sushihangover/SupermodifiedServo/EagleFiles/render.JPG

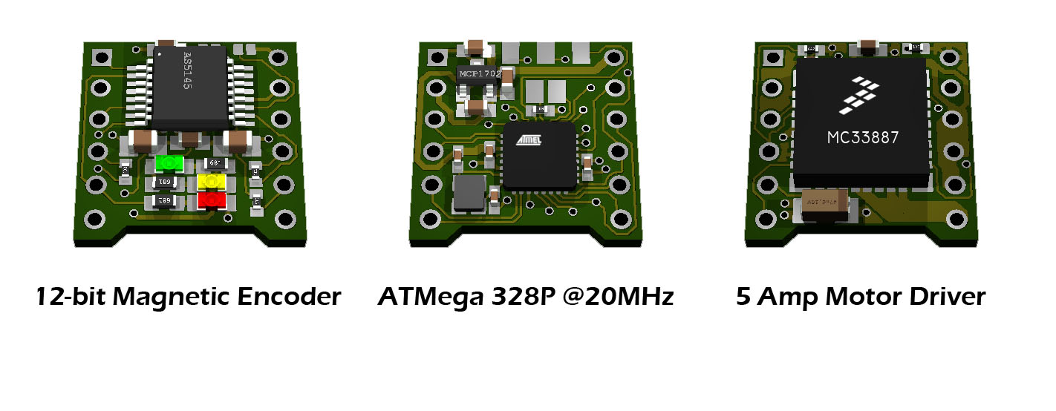
EagleFiles/render.JPG
