sushihangover/SupermodifiedServo/OldSite/MetalPotModification.pdf

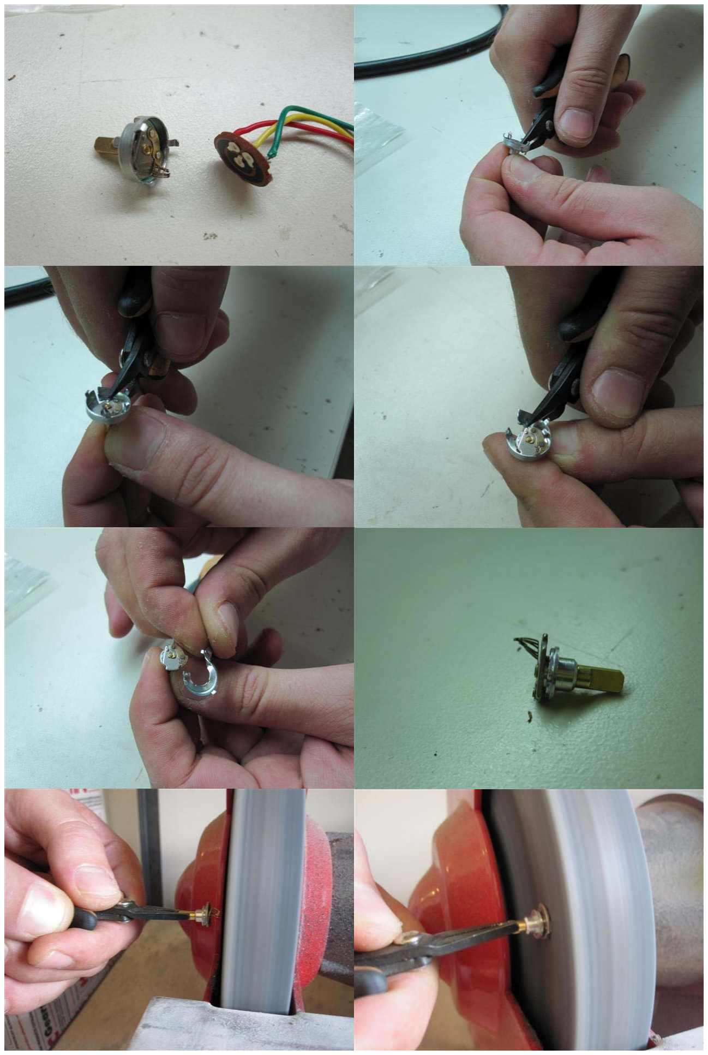
[picture p2: figure]

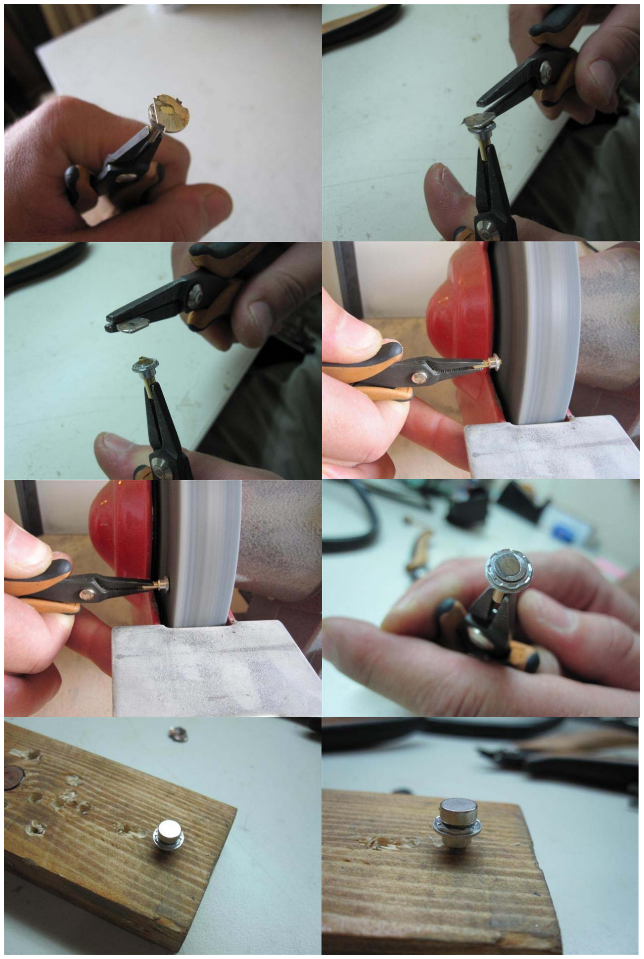
[picture p3: figure]
