sushihangover/SupermodifiedServo/ArduinoApiC/Debug/BuildLog.htm

Build Log

| | Rebuild started: Project: SuperModifiedMaster, Configuration: Debug|Win32

Command Lines

| | Creating temporary file "C:\DOCUME~1\giannis\LOCALS~1\Temp\BAT00000117923924.bat" with contents [ @echo off make clean make all if errorlevel 1 goto VCReportError goto VCEnd :VCReportError echo Project : error PRJ0019: A tool returned an error code from "Performing Makefile project actions" exit 1 :VCEnd ] Creating command line "C:\DOCUME~1\giannis\LOCALS~1\Temp\BAT00000117923924.bat"

Output Window

Performing Makefile project actions
-------- begin --------
Cleaning project:
rm -f main.hex
rm -f main.eep
rm -f main.cof
rm -f main.elf
rm -f main.map
rm -f main.sym
rm -f main.lss
rm -f ./obj/zoAdc.o ./obj/zoSystemTimer.o ./obj/zoI2c.o ./obj/zoBuffer.o ./obj/zoUart.o ./obj/zoError.o ./obj/zoProtocol.o ./obj/zoProtocolI2c.o ./obj/zoProtocolUart.o ./obj/zoCommands.o ./obj/zoSmsMaster.o ./obj/main.o
rm -f ./obj/zoAdc.lst ./obj/zoSystemTimer.lst ./obj/zoI2c.lst ./obj/zoBuffer.lst ./obj/zoUart.lst ./obj/zoError.lst ./obj/zoProtocol.lst ./obj/zoProtocolI2c.lst ./obj/zoProtocolUart.lst ./obj/zoCommands.lst ./obj/zoSmsMaster.lst ./obj/main.lst
rm -f zoAdc.s zoSystemTimer.s zoI2c.s zoBuffer.s zoUart.s zoError.s zoProtocol.s zoProtocolI2c.s zoProtocolUart.s zoCommands.s zoSmsMaster.s main.s
rm -f zoAdc.d zoSystemTimer.d zoI2c.d zoBuffer.d zoUart.d zoError.d zoProtocol.d zoProtocolI2c.d zoProtocolUart.d zoCommands.d zoSmsMaster.d main.d
rm -f zoAdc.i zoSystemTimer.i zoI2c.i zoBuffer.i zoUart.i zoError.i zoProtocol.i zoProtocolI2c.i zoProtocolUart.i zoCommands.i zoSmsMaster.i main.i
rm -rf .dep
-------- end --------
-------- begin --------
avr-gcc (WinAVR 20100110) 4.3.3
Copyright (C) 2008 Free Software Foundation, Inc.
This is free software; see the source for copying conditions. There is NO
warranty; not even for MERCHANTABILITY or FITNESS FOR A PARTICULAR PURPOSE.
Compiling C: zoAdc.c
avr-gcc -c -mmcu=atmega328p -I. -gdwarf-2 -DF_CPU=16000000UL -O2 -funsigned-char -funsigned-bitfields -fpack-struct -fshort-enums -Wall -Wstrict-prototypes -Wa,-adhlns=./obj/zoAdc.lst -std=gnu99 -MMD -MP -MF .dep/zoAdc.o.d zoAdc.c -o obj/zoAdc.o
Compiling C: zoSystemTimer.c
avr-gcc -c -mmcu=atmega328p -I. -gdwarf-2 -DF_CPU=16000000UL -O2 -funsigned-char -funsigned-bitfields -fpack-struct -fshort-enums -Wall -Wstrict-prototypes -Wa,-adhlns=./obj/zoSystemTimer.lst -std=gnu99 -MMD -MP -MF .dep/zoSystemTimer.o.d zoSystemTimer.c -o obj/zoSystemTimer.o
Compiling C: zoI2c.c
avr-gcc -c -mmcu=atmega328p -I. -gdwarf-2 -DF_CPU=16000000UL -O2 -funsigned-char -funsigned-bitfields -fpack-struct -fshort-enums -Wall -Wstrict-prototypes -Wa,-adhlns=./obj/zoI2c.lst -std=gnu99 -MMD -MP -MF .dep/zoI2c.o.d zoI2c.c -o obj/zoI2c.o
Compiling C: zoBuffer.c
avr-gcc -c -mmcu=atmega328p -I. -gdwarf-2 -DF_CPU=16000000UL -O2 -funsigned-char -funsigned-bitfields -fpack-struct -fshort-enums -Wall -Wstrict-prototypes -Wa,-adhlns=./obj/zoBuffer.lst -std=gnu99 -MMD -MP -MF .dep/zoBuffer.o.d zoBuffer.c -o obj/zoBuffer.o
Compiling C: zoUart.c
avr-gcc -c -mmcu=atmega328p -I. -gdwarf-2 -DF_CPU=16000000UL -O2 -funsigned-char -funsigned-bitfields -fpack-struct -fshort-enums -Wall -Wstrict-prototypes -Wa,-adhlns=./obj/zoUart.lst -std=gnu99 -MMD -MP -MF .dep/zoUart.o.d zoUart.c -o obj/zoUart.o
Compiling C: zoError.c
avr-gcc -c -mmcu=atmega328p -I. -gdwarf-2 -DF_CPU=16000000UL -O2 -funsigned-char -funsigned-bitfields -fpack-struct -fshort-enums -Wall -Wstrict-prototypes -Wa,-adhlns=./obj/zoError.lst -std=gnu99 -MMD -MP -MF .dep/zoError.o.d zoError.c -o obj/zoError.o
Compiling C: zoProtocol.c
avr-gcc -c -mmcu=atmega328p -I. -gdwarf-2 -DF_CPU=16000000UL -O2 -funsigned-char -funsigned-bitfields -fpack-struct -fshort-enums -Wall -Wstrict-prototypes -Wa,-adhlns=./obj/zoProtocol.lst -std=gnu99 -MMD -MP -MF .dep/zoProtocol.o.d zoProtocol.c -o obj/zoProtocol.o
Compiling C: zoProtocolI2c.c
avr-gcc -c -mmcu=atmega328p -I. -gdwarf-2 -DF_CPU=16000000UL -O2 -funsigned-char -funsigned-bitfields -fpack-struct -fshort-enums -Wall -Wstrict-prototypes -Wa,-adhlns=./obj/zoProtocolI2c.lst -std=gnu99 -MMD -MP -MF .dep/zoProtocolI2c.o.d zoProtocolI2c.c -o obj/zoProtocolI2c.o
Compiling C: zoProtocolUart.c
avr-gcc -c -mmcu=atmega328p -I. -gdwarf-2 -DF_CPU=16000000UL -O2 -funsigned-char -funsigned-bitfields -fpack-struct -fshort-enums -Wall -Wstrict-prototypes -Wa,-adhlns=./obj/zoProtocolUart.lst -std=gnu99 -MMD -MP -MF .dep/zoProtocolUart.o.d zoProtocolUart.c -o obj/zoProtocolUart.o
Compiling C: zoCommands.c
avr-gcc -c -mmcu=atmega328p -I. -gdwarf-2 -DF_CPU=16000000UL -O2 -funsigned-char -funsigned-bitfields -fpack-struct -fshort-enums -Wall -Wstrict-prototypes -Wa,-adhlns=./obj/zoCommands.lst -std=gnu99 -MMD -MP -MF .dep/zoCommands.o.d zoCommands.c -o obj/zoCommands.o
Compiling C: zoSmsMaster.c
avr-gcc -c -mmcu=atmega328p -I. -gdwarf-2 -DF_CPU=16000000UL -O2 -funsigned-char -funsigned-bitfields -fpack-struct -fshort-enums -Wall -Wstrict-prototypes -Wa,-adhlns=./obj/zoSmsMaster.lst -std=gnu99 -MMD -MP -MF .dep/zoSmsMaster.o.d zoSmsMaster.c -o obj/zoSmsMaster.o
Compiling C: main.c
avr-gcc -c -mmcu=atmega328p -I. -gdwarf-2 -DF_CPU=16000000UL -O2 -funsigned-char -funsigned-bitfields -fpack-struct -fshort-enums -Wall -Wstrict-prototypes -Wa,-adhlns=./obj/main.lst -std=gnu99 -MMD -MP -MF .dep/main.o.d main.c -o obj/main.o
Linking: main.elf
avr-gcc -mmcu=atmega328p -I. -gdwarf-2 -DF_CPU=16000000UL -O2 -funsigned-char -funsigned-bitfields -fpack-struct -fshort-enums -Wall -Wstrict-prototypes -Wa,-adhlns=obj/zoAdc.o -std=gnu99 -MMD -MP -MF .dep/main.elf.d obj/zoAdc.o obj/zoSystemTimer.o obj/zoI2c.o obj/zoBuffer.o obj/zoUart.o obj/zoError.o obj/zoProtocol.o obj/zoProtocolI2c.o obj/zoProtocolUart.o obj/zoCommands.o obj/zoSmsMaster.o obj/main.o --output main.elf -Wl,-Map=main.map,--cref -lm
Creating load file for Flash: main.hex
avr-objcopy -O ihex -R .eeprom -R .fuse -R .lock main.elf main.hex
Creating load file for EEPROM: main.eep
avr-objcopy -j .eeprom --set-section-flags=.eeprom="alloc,load" \
--change-section-lma .eeprom=0 --no-change-warnings -O ihex main.elf main.eep || exit 0
Creating Extended Listing: main.lss
avr-objdump -h -S -z main.elf > main.lss
Creating Symbol Table: main.sym
avr-nm -n main.elf > main.sym
Size after:
AVR Memory Usage
----------------
Device: atmega328p
Program: 11598 bytes (35.4% Full)
(.text + .data + .bootloader)
Data: 315 bytes (15.4% Full)
(.data + .bss + .noinit)
-------- end --------

Results

| | Build log was saved at "file://d:\01server\01mech\Products\Supermodified\Technical\Source\svn\ArduinoApiC\Debug\BuildLog.htm" SuperModifiedMaster - 0 error(s), 0 warning(s)
