sushihangover/SupermodifiedServo/SuperModified.V2.32bit.Velocities/Debug/BuildLog.htm

Build Log

| | Rebuild started: Project: zoSuperModified, Configuration: Debug|Win32

Command Lines

| | Creating temporary file "C:\DOCUME~1\giannis\LOCALS~1\Temp\BAT00000214723364.bat" with contents [ @echo off make clean make all if errorlevel 1 goto VCReportError goto VCEnd :VCReportError echo Project : error PRJ0019: A tool returned an error code from "Performing Makefile project actions" exit 1 :VCEnd ] Creating command line "C:\DOCUME~1\giannis\LOCALS~1\Temp\BAT00000214723364.bat"

Output Window

Performing Makefile project actions
-------- begin --------
Cleaning project:
rm -f main.hex
rm -f main.eep
rm -f main.cof
rm -f main.elf
rm -f main.map
rm -f main.sym
rm -f main.lss
rm -f ./obj/zoError.o ./obj/zoSystemTimer.o ./obj/zoProtocol.o ./obj/zoEncoder.o ./obj/zoMotor.o ./obj/zoPid.o ./obj/zoSms.o ./obj/zoSmsError.o ./obj/zoCommands.o ./obj/zoAdc.o ./obj/zoSpi.o ./obj/zoI2c.o ./obj/zoProtocolI2c.o ./obj/zoUart.o ./obj/zoProtocolUart.o ./obj/zoBuffer.o ./obj/zoIcp.o ./obj/zoProtocolRcServo.o ./obj/main.o
rm -f ./obj/zoError.lst ./obj/zoSystemTimer.lst ./obj/zoProtocol.lst ./obj/zoEncoder.lst ./obj/zoMotor.lst ./obj/zoPid.lst ./obj/zoSms.lst ./obj/zoSmsError.lst ./obj/zoCommands.lst ./obj/zoAdc.lst ./obj/zoSpi.lst ./obj/zoI2c.lst ./obj/zoProtocolI2c.lst ./obj/zoUart.lst ./obj/zoProtocolUart.lst ./obj/zoBuffer.lst ./obj/zoIcp.lst ./obj/zoProtocolRcServo.lst ./obj/main.lst
rm -f zoError.s zoSystemTimer.s zoProtocol.s zoEncoder.s zoMotor.s zoPid.s zoSms.s zoSmsError.s zoCommands.s zoAdc.s zoSpi.s zoI2c.s zoProtocolI2c.s zoUart.s zoProtocolUart.s zoBuffer.s zoIcp.s zoProtocolRcServo.s main.s
rm -f zoError.d zoSystemTimer.d zoProtocol.d zoEncoder.d zoMotor.d zoPid.d zoSms.d zoSmsError.d zoCommands.d zoAdc.d zoSpi.d zoI2c.d zoProtocolI2c.d zoUart.d zoProtocolUart.d zoBuffer.d zoIcp.d zoProtocolRcServo.d main.d
rm -f zoError.i zoSystemTimer.i zoProtocol.i zoEncoder.i zoMotor.i zoPid.i zoSms.i zoSmsError.i zoCommands.i zoAdc.i zoSpi.i zoI2c.i zoProtocolI2c.i zoUart.i zoProtocolUart.i zoBuffer.i zoIcp.i zoProtocolRcServo.i main.i
rm -rf .dep
-------- end --------
-------- begin --------
avr-gcc (WinAVR 20100110) 4.3.3
Copyright (C) 2008 Free Software Foundation, Inc.
This is free software; see the source for copying conditions. There is NO
warranty; not even for MERCHANTABILITY or FITNESS FOR A PARTICULAR PURPOSE.
Compiling C: zoError.c
avr-gcc -c -mmcu=atmega328p -I. -gdwarf-2 -DF_CPU=20000000UL -DZO_I2C_ENABLED= -DZO_UART_ENABLED= -DZO_RCSERVO_ENABLED= -DZO_ANALOG_ENABLED= -O2 -funsigned-char -funsigned-bitfields -fpack-struct -fshort-enums -Wall -Wstrict-prototypes -Wa,-adhlns=./obj/zoError.lst -std=gnu99 -MMD -MP -MF .dep/zoError.o.d zoError.c -o obj/zoError.o
Compiling C: zoSystemTimer.c
avr-gcc -c -mmcu=atmega328p -I. -gdwarf-2 -DF_CPU=20000000UL -DZO_I2C_ENABLED= -DZO_UART_ENABLED= -DZO_RCSERVO_ENABLED= -DZO_ANALOG_ENABLED= -O2 -funsigned-char -funsigned-bitfields -fpack-struct -fshort-enums -Wall -Wstrict-prototypes -Wa,-adhlns=./obj/zoSystemTimer.lst -std=gnu99 -MMD -MP -MF .dep/zoSystemTimer.o.d zoSystemTimer.c -o obj/zoSystemTimer.o
Compiling C: zoProtocol.c
avr-gcc -c -mmcu=atmega328p -I. -gdwarf-2 -DF_CPU=20000000UL -DZO_I2C_ENABLED= -DZO_UART_ENABLED= -DZO_RCSERVO_ENABLED= -DZO_ANALOG_ENABLED= -O2 -funsigned-char -funsigned-bitfields -fpack-struct -fshort-enums -Wall -Wstrict-prototypes -Wa,-adhlns=./obj/zoProtocol.lst -std=gnu99 -MMD -MP -MF .dep/zoProtocol.o.d zoProtocol.c -o obj/zoProtocol.o
Compiling C: zoEncoder.c
avr-gcc -c -mmcu=atmega328p -I. -gdwarf-2 -DF_CPU=20000000UL -DZO_I2C_ENABLED= -DZO_UART_ENABLED= -DZO_RCSERVO_ENABLED= -DZO_ANALOG_ENABLED= -O2 -funsigned-char -funsigned-bitfields -fpack-struct -fshort-enums -Wall -Wstrict-prototypes -Wa,-adhlns=./obj/zoEncoder.lst -std=gnu99 -MMD -MP -MF .dep/zoEncoder.o.d zoEncoder.c -o obj/zoEncoder.o
Compiling C: zoMotor.c
avr-gcc -c -mmcu=atmega328p -I. -gdwarf-2 -DF_CPU=20000000UL -DZO_I2C_ENABLED= -DZO_UART_ENABLED= -DZO_RCSERVO_ENABLED= -DZO_ANALOG_ENABLED= -O2 -funsigned-char -funsigned-bitfields -fpack-struct -fshort-enums -Wall -Wstrict-prototypes -Wa,-adhlns=./obj/zoMotor.lst -std=gnu99 -MMD -MP -MF .dep/zoMotor.o.d zoMotor.c -o obj/zoMotor.o
Compiling C: zoPid.c
avr-gcc -c -mmcu=atmega328p -I. -gdwarf-2 -DF_CPU=20000000UL -DZO_I2C_ENABLED= -DZO_UART_ENABLED= -DZO_RCSERVO_ENABLED= -DZO_ANALOG_ENABLED= -O2 -funsigned-char -funsigned-bitfields -fpack-struct -fshort-enums -Wall -Wstrict-prototypes -Wa,-adhlns=./obj/zoPid.lst -std=gnu99 -MMD -MP -MF .dep/zoPid.o.d zoPid.c -o obj/zoPid.o
Compiling C: zoSms.c
avr-gcc -c -mmcu=atmega328p -I. -gdwarf-2 -DF_CPU=20000000UL -DZO_I2C_ENABLED= -DZO_UART_ENABLED= -DZO_RCSERVO_ENABLED= -DZO_ANALOG_ENABLED= -O2 -funsigned-char -funsigned-bitfields -fpack-struct -fshort-enums -Wall -Wstrict-prototypes -Wa,-adhlns=./obj/zoSms.lst -std=gnu99 -MMD -MP -MF .dep/zoSms.o.d zoSms.c -o obj/zoSms.o
Compiling C: zoSmsError.c
avr-gcc -c -mmcu=atmega328p -I. -gdwarf-2 -DF_CPU=20000000UL -DZO_I2C_ENABLED= -DZO_UART_ENABLED= -DZO_RCSERVO_ENABLED= -DZO_ANALOG_ENABLED= -O2 -funsigned-char -funsigned-bitfields -fpack-struct -fshort-enums -Wall -Wstrict-prototypes -Wa,-adhlns=./obj/zoSmsError.lst -std=gnu99 -MMD -MP -MF .dep/zoSmsError.o.d zoSmsError.c -o obj/zoSmsError.o
Compiling C: zoCommands.c
avr-gcc -c -mmcu=atmega328p -I. -gdwarf-2 -DF_CPU=20000000UL -DZO_I2C_ENABLED= -DZO_UART_ENABLED= -DZO_RCSERVO_ENABLED= -DZO_ANALOG_ENABLED= -O2 -funsigned-char -funsigned-bitfields -fpack-struct -fshort-enums -Wall -Wstrict-prototypes -Wa,-adhlns=./obj/zoCommands.lst -std=gnu99 -MMD -MP -MF .dep/zoCommands.o.d zoCommands.c -o obj/zoCommands.o
Compiling C: zoAdc.c
avr-gcc -c -mmcu=atmega328p -I. -gdwarf-2 -DF_CPU=20000000UL -DZO_I2C_ENABLED= -DZO_UART_ENABLED= -DZO_RCSERVO_ENABLED= -DZO_ANALOG_ENABLED= -O2 -funsigned-char -funsigned-bitfields -fpack-struct -fshort-enums -Wall -Wstrict-prototypes -Wa,-adhlns=./obj/zoAdc.lst -std=gnu99 -MMD -MP -MF .dep/zoAdc.o.d zoAdc.c -o obj/zoAdc.o
Compiling C: zoSpi.c
avr-gcc -c -mmcu=atmega328p -I. -gdwarf-2 -DF_CPU=20000000UL -DZO_I2C_ENABLED= -DZO_UART_ENABLED= -DZO_RCSERVO_ENABLED= -DZO_ANALOG_ENABLED= -O2 -funsigned-char -funsigned-bitfields -fpack-struct -fshort-enums -Wall -Wstrict-prototypes -Wa,-adhlns=./obj/zoSpi.lst -std=gnu99 -MMD -MP -MF .dep/zoSpi.o.d zoSpi.c -o obj/zoSpi.o
Compiling C: zoI2c.c
avr-gcc -c -mmcu=atmega328p -I. -gdwarf-2 -DF_CPU=20000000UL -DZO_I2C_ENABLED= -DZO_UART_ENABLED= -DZO_RCSERVO_ENABLED= -DZO_ANALOG_ENABLED= -O2 -funsigned-char -funsigned-bitfields -fpack-struct -fshort-enums -Wall -Wstrict-prototypes -Wa,-adhlns=./obj/zoI2c.lst -std=gnu99 -MMD -MP -MF .dep/zoI2c.o.d zoI2c.c -o obj/zoI2c.o
Compiling C: zoProtocolI2c.c
avr-gcc -c -mmcu=atmega328p -I. -gdwarf-2 -DF_CPU=20000000UL -DZO_I2C_ENABLED= -DZO_UART_ENABLED= -DZO_RCSERVO_ENABLED= -DZO_ANALOG_ENABLED= -O2 -funsigned-char -funsigned-bitfields -fpack-struct -fshort-enums -Wall -Wstrict-prototypes -Wa,-adhlns=./obj/zoProtocolI2c.lst -std=gnu99 -MMD -MP -MF .dep/zoProtocolI2c.o.d zoProtocolI2c.c -o obj/zoProtocolI2c.o
Compiling C: zoUart.c
avr-gcc -c -mmcu=atmega328p -I. -gdwarf-2 -DF_CPU=20000000UL -DZO_I2C_ENABLED= -DZO_UART_ENABLED= -DZO_RCSERVO_ENABLED= -DZO_ANALOG_ENABLED= -O2 -funsigned-char -funsigned-bitfields -fpack-struct -fshort-enums -Wall -Wstrict-prototypes -Wa,-adhlns=./obj/zoUart.lst -std=gnu99 -MMD -MP -MF .dep/zoUart.o.d zoUart.c -o obj/zoUart.o
Compiling C: zoProtocolUart.c
avr-gcc -c -mmcu=atmega328p -I. -gdwarf-2 -DF_CPU=20000000UL -DZO_I2C_ENABLED= -DZO_UART_ENABLED= -DZO_RCSERVO_ENABLED= -DZO_ANALOG_ENABLED= -O2 -funsigned-char -funsigned-bitfields -fpack-struct -fshort-enums -Wall -Wstrict-prototypes -Wa,-adhlns=./obj/zoProtocolUart.lst -std=gnu99 -MMD -MP -MF .dep/zoProtocolUart.o.d zoProtocolUart.c -o obj/zoProtocolUart.o
Compiling C: zoBuffer.c
avr-gcc -c -mmcu=atmega328p -I. -gdwarf-2 -DF_CPU=20000000UL -DZO_I2C_ENABLED= -DZO_UART_ENABLED= -DZO_RCSERVO_ENABLED= -DZO_ANALOG_ENABLED= -O2 -funsigned-char -funsigned-bitfields -fpack-struct -fshort-enums -Wall -Wstrict-prototypes -Wa,-adhlns=./obj/zoBuffer.lst -std=gnu99 -MMD -MP -MF .dep/zoBuffer.o.d zoBuffer.c -o obj/zoBuffer.o
Compiling C: zoIcp.c
avr-gcc -c -mmcu=atmega328p -I. -gdwarf-2 -DF_CPU=20000000UL -DZO_I2C_ENABLED= -DZO_UART_ENABLED= -DZO_RCSERVO_ENABLED= -DZO_ANALOG_ENABLED= -O2 -funsigned-char -funsigned-bitfields -fpack-struct -fshort-enums -Wall -Wstrict-prototypes -Wa,-adhlns=./obj/zoIcp.lst -std=gnu99 -MMD -MP -MF .dep/zoIcp.o.d zoIcp.c -o obj/zoIcp.o
Compiling C: zoProtocolRcServo.c
avr-gcc -c -mmcu=atmega328p -I. -gdwarf-2 -DF_CPU=20000000UL -DZO_I2C_ENABLED= -DZO_UART_ENABLED= -DZO_RCSERVO_ENABLED= -DZO_ANALOG_ENABLED= -O2 -funsigned-char -funsigned-bitfields -fpack-struct -fshort-enums -Wall -Wstrict-prototypes -Wa,-adhlns=./obj/zoProtocolRcServo.lst -std=gnu99 -MMD -MP -MF .dep/zoProtocolRcServo.o.d zoProtocolRcServo.c -o obj/zoProtocolRcServo.o
Compiling C: main.c
avr-gcc -c -mmcu=atmega328p -I. -gdwarf-2 -DF_CPU=20000000UL -DZO_I2C_ENABLED= -DZO_UART_ENABLED= -DZO_RCSERVO_ENABLED= -DZO_ANALOG_ENABLED= -O2 -funsigned-char -funsigned-bitfields -fpack-struct -fshort-enums -Wall -Wstrict-prototypes -Wa,-adhlns=./obj/main.lst -std=gnu99 -MMD -MP -MF .dep/main.o.d main.c -o obj/main.o
Linking: main.elf
avr-gcc -mmcu=atmega328p -I. -gdwarf-2 -DF_CPU=20000000UL -DZO_I2C_ENABLED= -DZO_UART_ENABLED= -DZO_RCSERVO_ENABLED= -DZO_ANALOG_ENABLED= -O2 -funsigned-char -funsigned-bitfields -fpack-struct -fshort-enums -Wall -Wstrict-prototypes -Wa,-adhlns=obj/zoError.o -std=gnu99 -MMD -MP -MF .dep/main.elf.d obj/zoError.o obj/zoSystemTimer.o obj/zoProtocol.o obj/zoEncoder.o obj/zoMotor.o obj/zoPid.o obj/zoSms.o obj/zoSmsError.o obj/zoCommands.o obj/zoAdc.o obj/zoSpi.o obj/zoI2c.o obj/zoProtocolI2c.o obj/zoUart.o obj/zoProtocolUart.o obj/zoBuffer.o obj/zoIcp.o obj/zoProtocolRcServo.o obj/main.o --output main.elf -Wl,-Map=main.map,--cref -lm
Creating load file for Flash: main.hex
avr-objcopy -O ihex -R .eeprom -R .fuse -R .lock main.elf main.hex
Creating load file for EEPROM: main.eep
avr-objcopy -j .eeprom --set-section-flags=.eeprom="alloc,load" \
--change-section-lma .eeprom=0 --no-change-warnings -O ihex main.elf main.eep || exit 0
Creating Extended Listing: main.lss
avr-objdump -h -S -z main.elf > main.lss
Creating Symbol Table: main.sym
avr-nm -n main.elf > main.sym
Size after:
AVR Memory Usage
----------------
Device: atmega328p
Program: 20242 bytes (61.8% Full)
(.text + .data + .bootloader)
Data: 600 bytes (29.3% Full)
(.data + .bss + .noinit)
-------- end --------

Results

| | Build log was saved at "file://d:\01server\01mech\Products\Supermodified\Technical\Source\svn\SuperModified.V2.32bit.Velocities\Debug\BuildLog.htm" zoSuperModified - 0 error(s), 0 warning(s)
