sushihangover/SupermodifiedServo/OldSite/MagEnc.Schematic.pdf

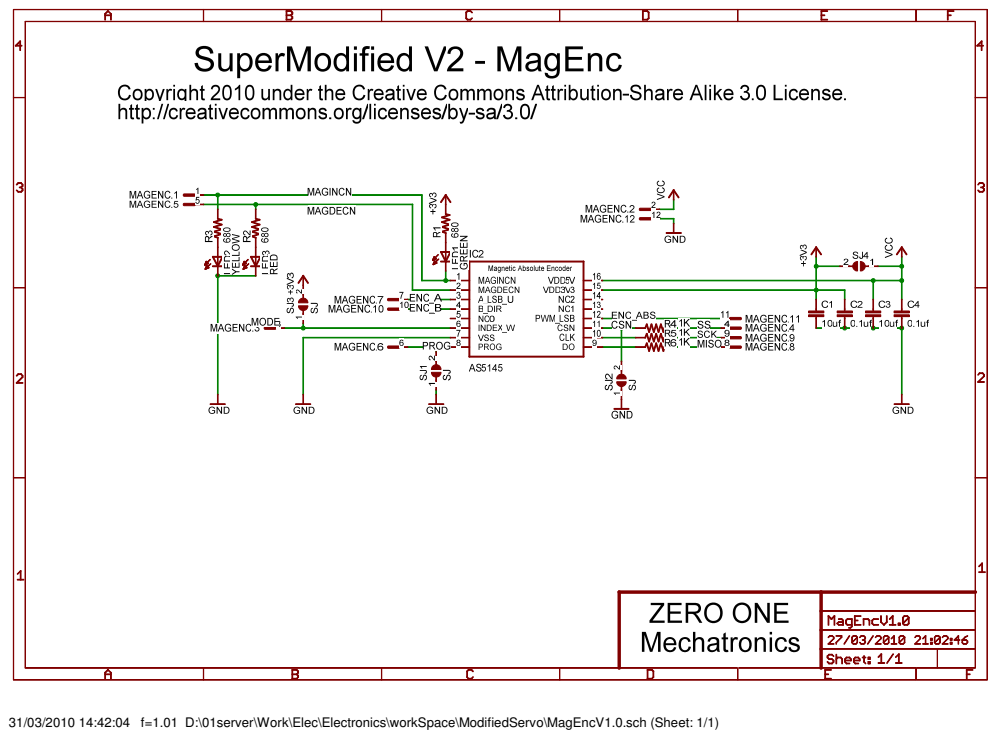
[picture p30: page 1]

31/03/2010 14:42:04 f=1.01 D:\01server\Work\Elec\Electronics\workSpace\ModifiedServo\MagEncV1.0.sch (Sheet: 1/1)
