sushihangover/SupermodifiedServo/OldSite/PicoMCU.schematic.pdf

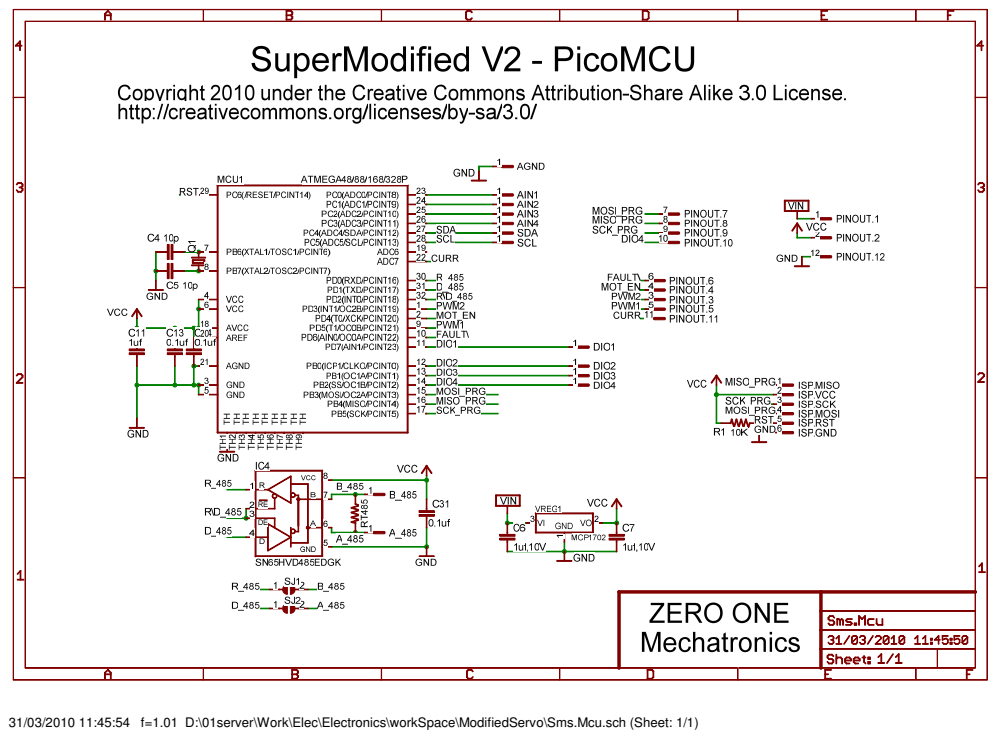
[picture p31: page 1]

31/03/2010 11:45:54 f=1.01 D:\01server\Work\Elec\Electronics\workSpace\ModifiedServo\Sms.Mcu.sch (Sheet: 1/1)
