sushihangover/SupermodifiedServo/OldSite/MD01.pdf

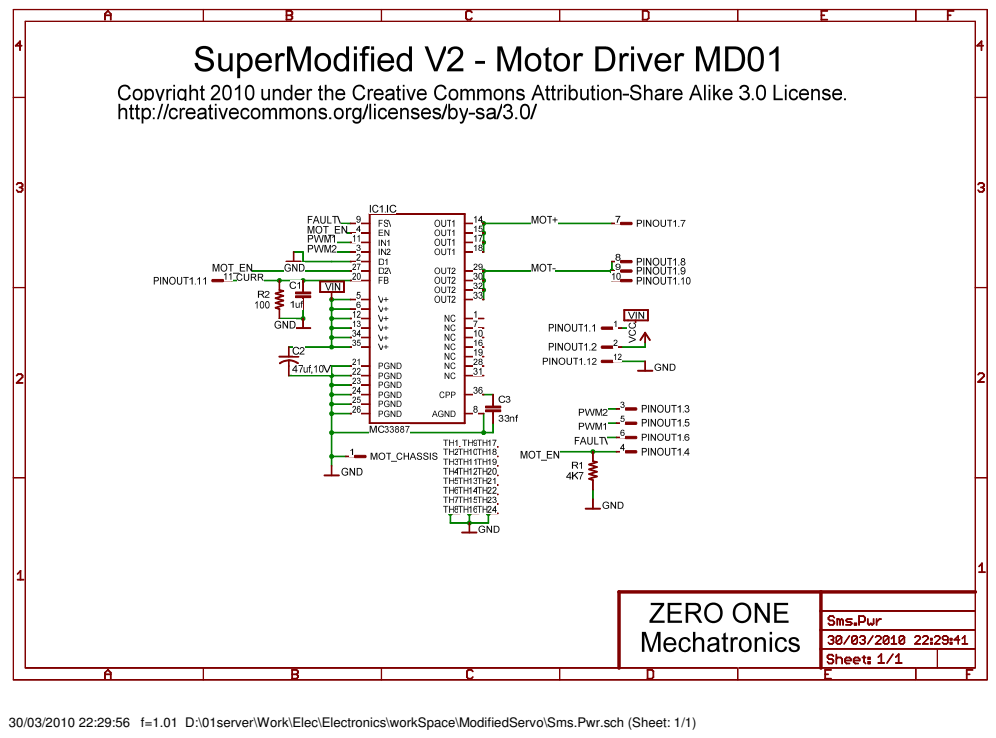
[picture p32: page 1]

30/03/2010 22:29:56 f=1.01 D:\01server\Work\Elec\Electronics\workSpace\ModifiedServo\Sms.Pwr.sch (Sheet: 1/1)
