sushihangover/SupermodifiedServo/SuperModified.V2.32bit.Velocities/main.c

//****************************************************************************************
//	File Name	: main.c 
//	Title		: file containing main()
//	Created		: 25.10.2010
//	Revised		:
//	Target MCU	: Atmel AVR
//	Author		: Sissakis Giannis
//  email		: info@01mech.com
//
//  Copyright (C) 2010 Zero One Mechatronics LP
//
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
//****************************************************************************************

#include "zoTypes.h"
#include "zoSms.h"
#include "zoSmsError.h"
#include "zoProtocol.h"
#include "zoCommands.h"
#include "zoProtocolRcServo.h"

#include "zoUart.h"
#include <util/delay.h>

int main(void)
{
	ZO_PROTOCOL_PACKET packetI2c,packetUart;
	ZO_PROTOCOL_HAL halI2c,halUart;
		
	//uncomment below two lines to restore defaults by programming the MCU
	//zoSmsRestoreDefaults();
	//while(1);
	
	//initialize all hardware and control
	zoSmsInit();		
	
	//initialize commands
	zoCommandsInit();

	//initialize i2c communications
	zoProtocolInit(ZO_PROTOCOL_HW_I2C,&halI2c,Sms.Settings.NodeID);
	zoProtocolSetBitrate(&halI2c,Sms.Settings.BaudI2C);
	zoProtocolSetLAM(&halI2c,Sms.Settings.localAcceptanceMask);
	
	//initialize uart communications
	zoProtocolInit(ZO_PROTOCOL_HW_HALF_DUPLEX_RS485,&halUart,Sms.Settings.NodeID);
	zoProtocolSetBitrate(&halUart,Sms.Settings.BaudUart);
	zoProtocolSetLAM(&halUart,Sms.Settings.localAcceptanceMask);

	//initialize PPM-VPM communication as per standard rc-servo communication
	zoProtocolRcServoInit();

	while(1)
	{
		//TODO:watchdog and fail-continue implementation		
		
		//poll the hardware for errors
		zoSmsErrorPoll();		
		
		//Parse RC-Servo input
		zoProtocolRcServoParse();

		//Parse I2C
		if(zoProtocolParse(&halI2c,&packetI2c))
		{
			//if there arent any other errors present, execute the command.
			if( zoErrorIsEmpty(&zoSmsError) )
			{
				//if the command was wrong, store errors so they can be indicated by 
				//the command response
				if( !zoCommandsServiceCommand(&packetI2c) )
					zoSmsErrorHandleServiceCommandFailure();
			}
			
			//respond to command, if we fail try another 5 times to respond
			if( !zoProtocolCommandResponse(&halI2c,&packetI2c,&zoSmsError) )
				zoSmsErrorHandleCommandResponseFailure(&halI2c,&packetI2c);
		}
		else
			zoSmsErrorHandleParseFailure(&halI2c,&packetI2c);


		//Parse Uart
		if(zoProtocolParse(&halUart,&packetUart))
		{
			//if there arent any other errors present, execute the command.
			if( zoErrorIsEmpty(&zoSmsError) )
			{
				//if the command was wrong, store errors so they can be indicated by 
				//the command response
				if( !zoCommandsServiceCommand(&packetUart) )
					zoSmsErrorHandleServiceCommandFailure();
			}
			
			//respond to command, if we fail try another 5 times to respond
			if( !zoProtocolCommandResponse(&halUart,&packetUart,&zoSmsError) )
				zoSmsErrorHandleCommandResponseFailure(&halUart,&packetUart);
		}
		else
			zoSmsErrorHandleParseFailure(&halUart,&packetUart);

	}

	return 0;
}
