sushihangover/SupermodifiedServo/avrlib/src/zoAdc.c

#include <avr/io.h>
#include <avr/interrupt.h>
#include <avr/sfr_defs.h>
#include "zoAdc.h"
#include "zoMcu.h"

#define ADC_PRESCALE_MASK		0x07
#define ADC_REFERENCE_MASK		0xC0
#define ADC_TRIGGER_MASK		0x07
#define ADC_CHANNEL_MASK		0x0F

//storage for adc results
static volatile u08 AdcCurrentChannel = 0;
static volatile u16 AdcResult[11] = {0,0,0,0,0,0,0,0,0,0,0};
static bool AdcChannelOn[11] = {FALSE,FALSE,FALSE,FALSE,FALSE,FALSE,
								FALSE,FALSE,FALSE,FALSE,FALSE};

// initialize a2d converter
void zoAdcInit(void)
{
	//DDRC = 0x00;
	//DIDR0 = 0x00;
	PRR &= ~_BV(PRADC);							// enable ADC power
	ADCSRA |= _BV(ADEN);							// enable ADC (turn on ADC power)
	zoAdcSetPrescaler(ZO_ADC_DEFAULT_PRESCALER);	// set default prescaler
	zoAdcSetReference(ZO_ADC_DEFAULT_REFERENCE);	// set default reference
	zoAdcSetTrigger(ZO_ADC_DEFAULT_TRIGGER);		// set free running mode
	ADMUX &= ~_BV(ADLAR);							// set to right-adjusted result
}

void zoAdcStartConversion(ZO_ADC_CHANNEL channel)
{
	//inform ISR where to put the conversion result
	enterCritical();
	AdcCurrentChannel = channel;
	exitCritical();

	//configure the MUX for the conversion
	if(channel <= ZO_ADC_CHANNEL_TEMPERATURE)
		ADMUX = (ADMUX & ~ADC_CHANNEL_MASK)|channel;	
	else
		ADMUX = (ADMUX & ~ADC_CHANNEL_MASK)|(channel+5);		
	ADCSRA |= _BV(ADSC)|_BV(ADIF);					// start free running conversions
}

inline bool zoAdcConversionCompleted(void)
{
	return ((bit_is_set(ADCSRA, ADSC)==1)?TRUE:FALSE);
}

inline void zoAdcSetPrescaler(ZO_ADC_PRESCALE prescale)
{
	ADCSRA = (ADCSRA & ~ADC_PRESCALE_MASK)|prescale;
}

inline void zoAdcSetReference(ZO_ADC_REFERENCE ref)
{
	ADMUX = (ADMUX & ~ADC_REFERENCE_MASK)|ref;
}

inline void zoAdcSetTrigger(ZO_ADC_TRIGGER trig)
{
	if(trig <= ZO_ADC_TRIGGER_TIMER1_ICP)
	{
		ADCSRB = (ADCSRB & ~ADC_TRIGGER_MASK)|trig;
		ADCSRA |= _BV(ADATE);							// enable auto triggering
	}
	else
	{
		ADCSRB = ADCSRB & ~ADC_TRIGGER_MASK;
		ADCSRA &= ~_BV(ADATE);							// disable auto triggering
	}
}

inline void zoAdcOff(void)
{
	ADCSRA &= ~_BV(ADIE);	//disable interrupts
	ADCSRA &= ~_BV(ADEN);	//turn off adc power
	PRR |= _BV(PRADC);		//disable ADC power
}

void zoAdcChannelEnable(ZO_ADC_CHANNEL channel)
{
	u08 ch;
	
	ch= (u08)channel; 
	
	enterCritical();
	AdcChannelOn[ch] = TRUE;
	exitCritical();
	
	ADCSRA |= _BV(ADIE);							// enable ADC interrupts
	sei();											// turn on interrupts (if not already on)
	
	zoAdcStartConversion(channel);					//be sure to trigger for autotriger modes
}

void zoAdcChannelDisable(ZO_ADC_CHANNEL channel)
{
	u08 ch;
	bool isAtLeastOneChannelEnabled = FALSE;
	
	ch= (u08)channel; 
	
	enterCritical();
	AdcChannelOn[ch] = FALSE;
	
	//scan all channels: if no channel is enabled disable ADC ISR
	for(ch=0; ch<11; ch++)
	{
		if(AdcChannelOn[ch])
		{
			isAtLeastOneChannelEnabled = TRUE;
			break;
		}
	}
	
	if(!isAtLeastOneChannelEnabled)
		ADCSRA &= ~_BV(ADIE);			//disable ADC interrupts
	
	exitCritical();
}

u16 zoAdcRead(ZO_ADC_CHANNEL channel)
{
	u16 result;
	u08 ch;
	
	ch = (u08)channel;

	enterCritical();
	result = AdcResult[ch];
	exitCritical();

	return result;
}

ISR(ADC_vect)
{
	AdcResult[AdcCurrentChannel] = ADCL;			// read in the result first ADCL
	AdcResult[AdcCurrentChannel] |= (ADCH<<8);	// then ADCH

	//scan next active channel
	do {
		AdcCurrentChannel++;
		if(AdcCurrentChannel > 10)
			AdcCurrentChannel = 0;
	}while( !AdcChannelOn[AdcCurrentChannel] );

	//configure mux for next conversion
	if(AdcCurrentChannel <= ZO_ADC_CHANNEL_TEMPERATURE)
		ADMUX = (ADMUX & ~ADC_CHANNEL_MASK)|AdcCurrentChannel;	
	else
		ADMUX = (ADMUX & ~ADC_CHANNEL_MASK)|(AdcCurrentChannel+5);	
}
