sushihangover/SupermodifiedServo/(notices)

Notices in the files:
SuperModified.V2.32bit.Velocities/zoCommands.c:
the Free Software Foundation, either version 3 of the License, or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
avrlib/src/zoBuffer.h:
version 3 of the License or any later version. This program is distributed in the hope
